ZeshuLiu/Joker60_V3.5/layout.jpg

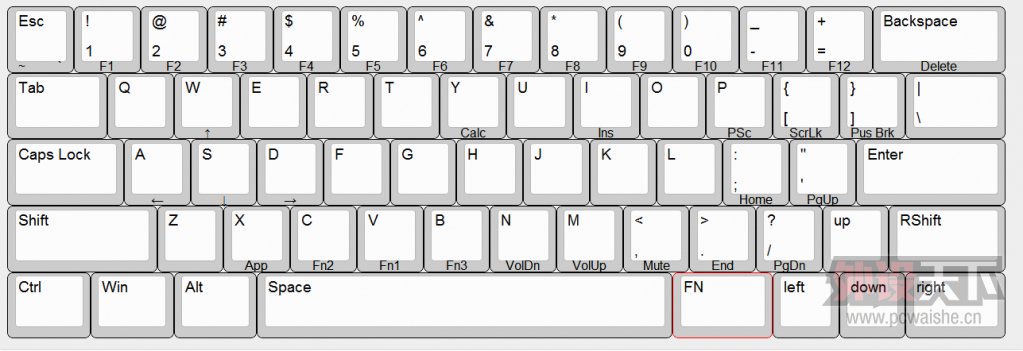
layout.jpg
