ZeshuLiu/Joker60_V3.5/Extension/Serial_DAP_Screen_back/Serial_Dap_Screen/Connector/SGDBM-08-014P-H10.stp

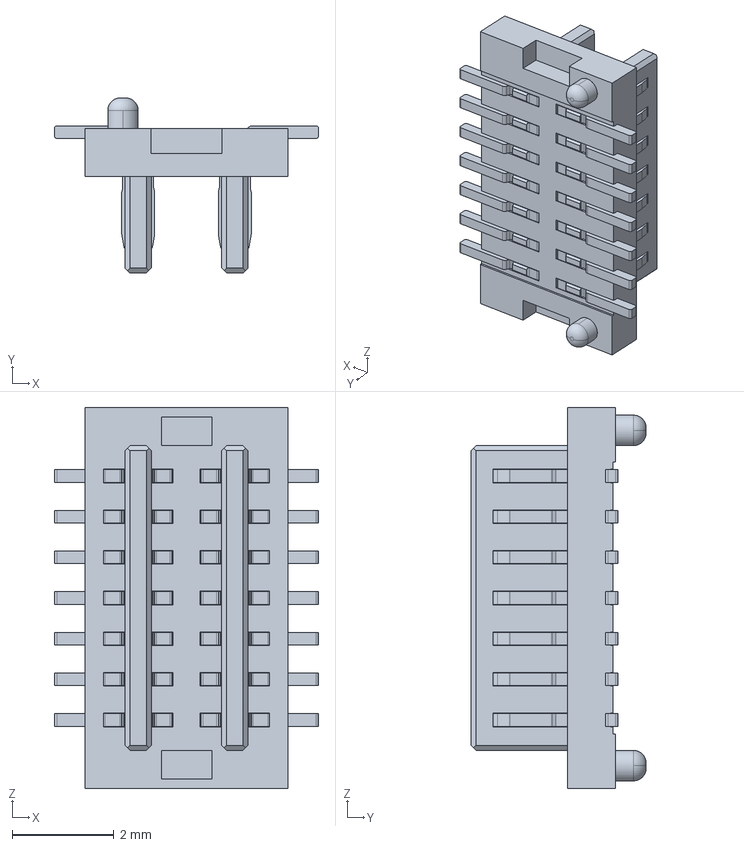
[picture p2: CAD file, 2023-10-21]
Extension/Serial_DAP_Screen_back/Serial_Dap_Screen/Connector/SGDBM-08-014P-H10.stp
5.20 x 3.45 x 7.50 mm
