ZeshuLiu/Joker60_V3.5/Joker60_V3.5/Connector_back/SGDBM-08-020P-H10.stp

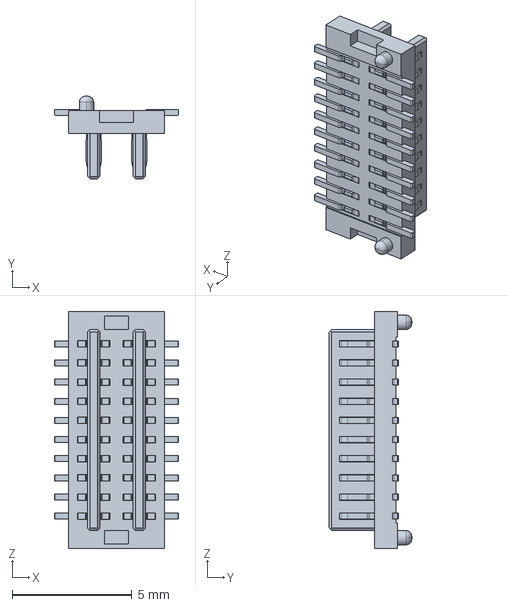
[picture p3: CAD file, 2023-10-21]
Joker60_V3.5/Connector_back/SGDBM-08-020P-H10.stp
5.20 x 3.45 x 9.90 mm
