ZeshuLiu/Joker60_V3.5/Joker60_V3.5/RP2040/RP2040.step

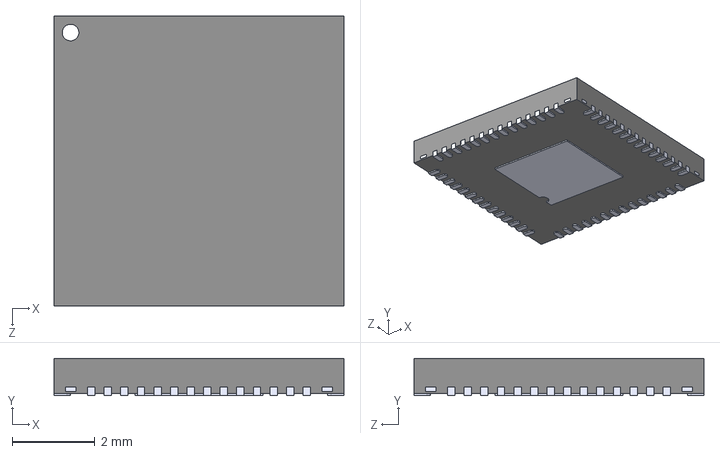
[picture p4: CAD file, 2023-08-13]
Joker60_V3.5/RP2040/RP2040.step
7.00 x 0.9 x 7.00 mm
