ZeshuLiu/Joker60_V3.5/Joker60_V3.5_CASE/Ver2/外壳.STEP

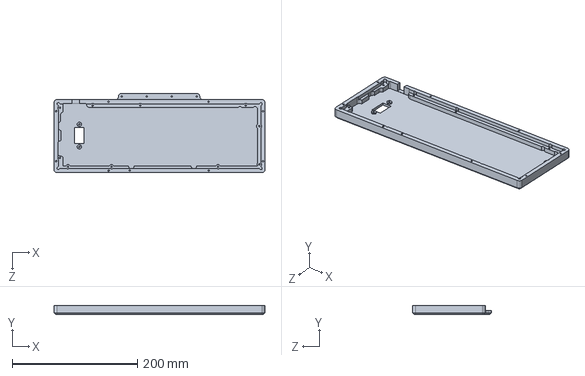
[picture p5: CAD file, 2026-01-21]
Joker60_V3.5_CASE/Ver2/外壳.STEP
337.3 x 15.0 x 126.9 mm
