ZeshuLiu/Joker60_V3.5/Joker60_V3.5_CASE/扩展/手机架子.SLDPRT

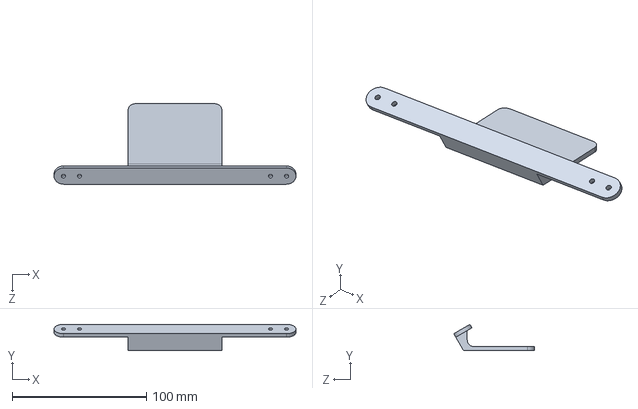
[picture p6: CAD file, 2023-11-28]
Joker60_V3.5_CASE/扩展/手机架子.SLDPRT
180.5 x 19.7 x 60.1 mm
