ZeshuLiu/Joker60_V3.5/Joker60_V3.5_CASE/Ver2/屏幕盖板.SLDPRT

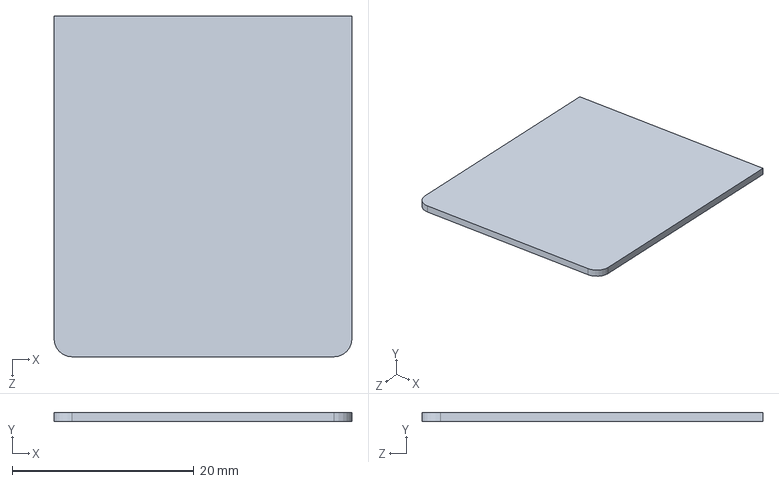
[picture p7: CAD file, 2026-01-21]
Joker60_V3.5_CASE/Ver2/屏幕盖板.SLDPRT
32.8 x 1.00 x 37.5 mm
