ZeshuLiu/Joker60_V3.5/Extension/Serial_DAP_Screen_back/Serial_Dap_Screen/Connector/SGDBF-08-014P-H30.stp

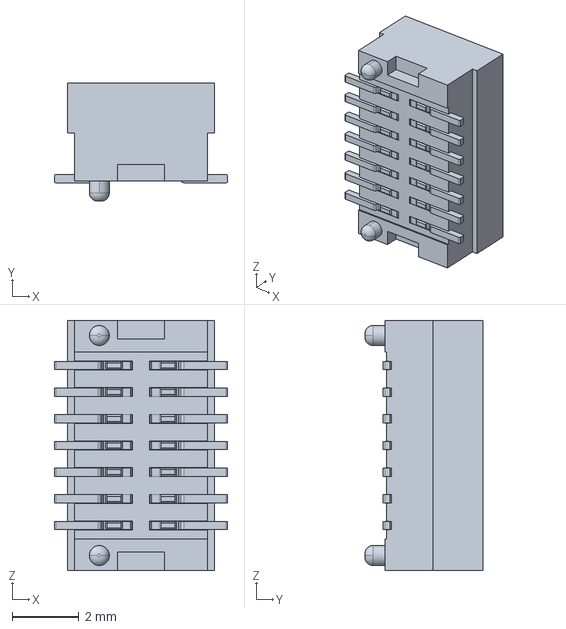
[picture p8: CAD file, 2023-08-15]
Extension/Serial_DAP_Screen_back/Serial_Dap_Screen/Connector/SGDBF-08-014P-H30.stp
5.20 x 3.55 x 7.50 mm
