ZeshuLiu/Joker60_V3.5/Joker60_V3.5/Connector_back/SGDBF-08-020P-H30.stp

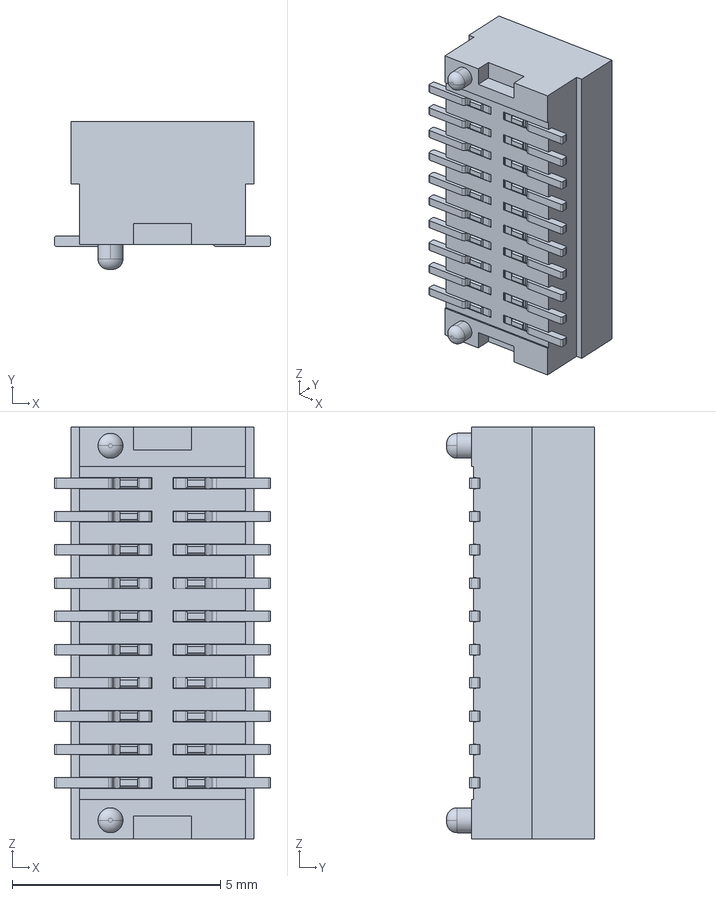
[picture p9: CAD file, 2023-08-15]
Joker60_V3.5/Connector_back/SGDBF-08-020P-H30.stp
5.20 x 3.55 x 9.90 mm
