ZeshuLiu/Joker60_V3.5/Joker60_V3.5_CASE/Ver2/盖子_Screen.STEP

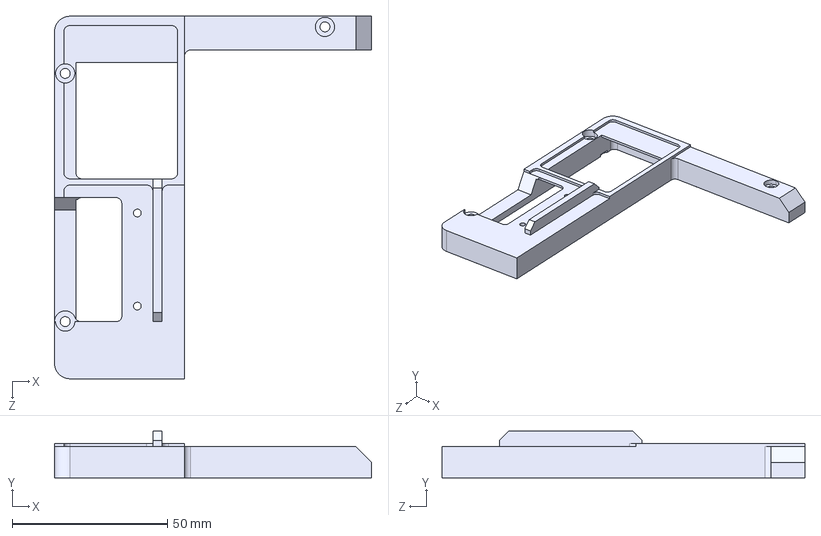
[picture p10: CAD file, 2026-01-21]
Joker60_V3.5_CASE/Ver2/盖子_Screen.STEP
102.2 x 15.0 x 116.9 mm
