ZeshuLiu/Joker60_V3.5/Joker60_V3.5_CASE/Ver2/盖子-space.SLDPRT

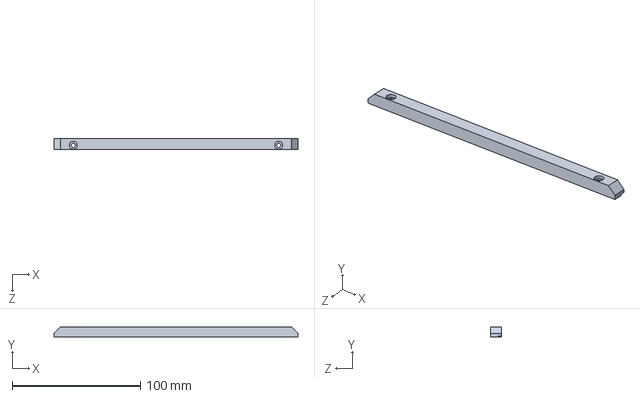
[picture p11: CAD file, 2026-01-21]
Joker60_V3.5_CASE/Ver2/盖子-space.SLDPRT
190.0 x 8.00 x 8.90 mm
