ZeshuLiu/Joker60_V3.5/Joker60_V3.5_CASE/Ver2/前脚垫.SLDPRT

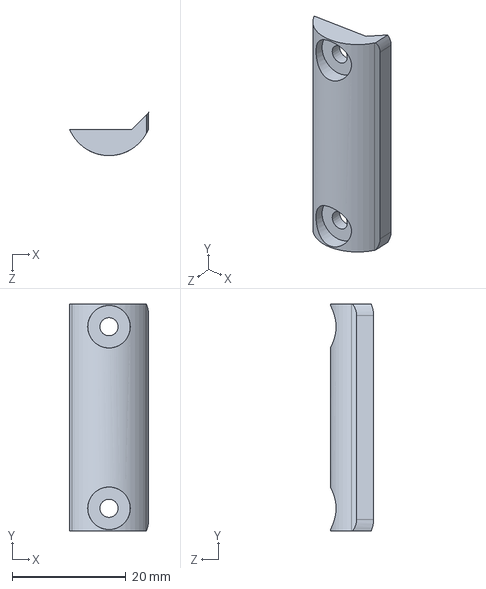
[picture p12: CAD file, 2026-01-21]
Joker60_V3.5_CASE/Ver2/前脚垫.SLDPRT
14.0 x 40.0 x 7.62 mm
