ZeshuLiu/Joker60_V3.5/Joker60_V3.5_CASE/Ver2/盖子-bacspace.SLDPRT

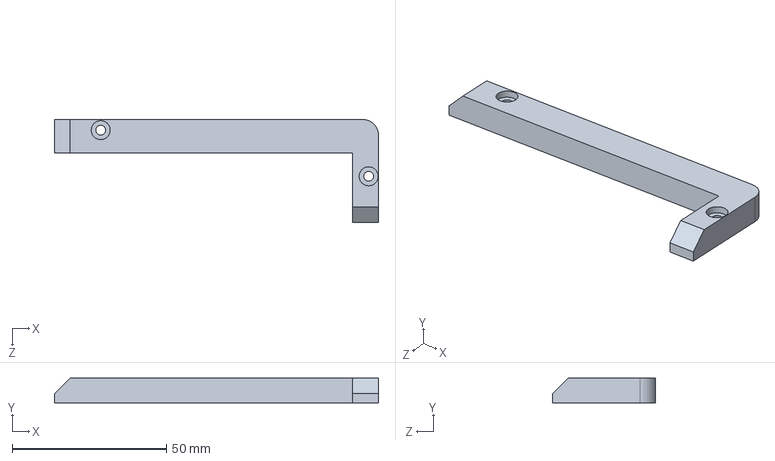
[picture p14: CAD file, 2026-01-21]
Joker60_V3.5_CASE/Ver2/盖子-bacspace.SLDPRT
105.2 x 8.00 x 33.4 mm
