ZeshuLiu/Joker60_V3.5/Joker60_V3.5_CASE/Ver2/1.69Screen.SLDPRT

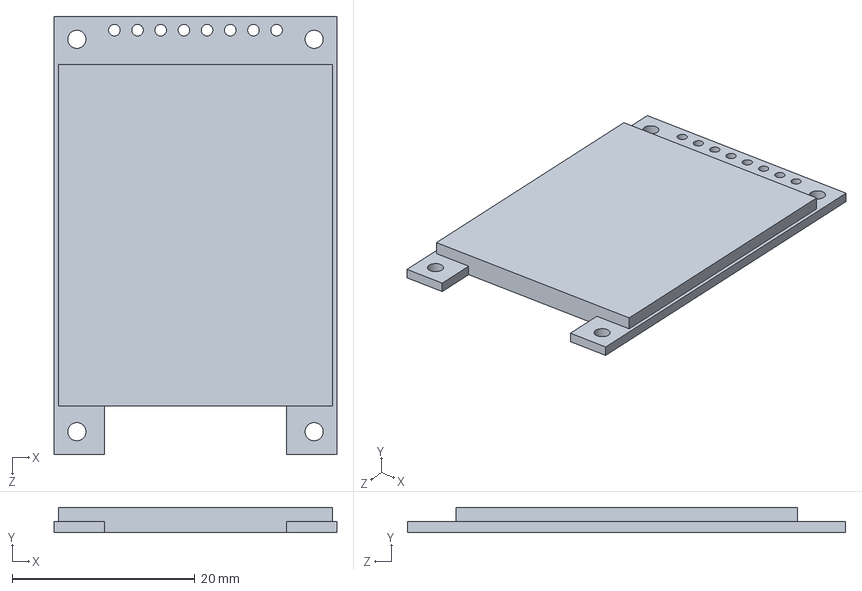
[picture p15: CAD file, 2025-12-26]
Joker60_V3.5_CASE/Ver2/1.69Screen.SLDPRT
31.0 x 2.76 x 48.0 mm
