ZeshuLiu/Joker60_V3.5/Joker60_V3.5_CASE/Ext/PhoneStand.SLDASM

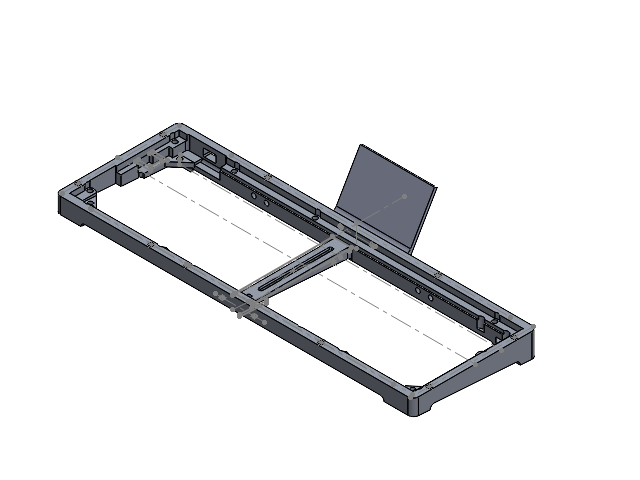
[picture p16: CAD file, 2023-11-28]
Joker60_V3.5_CASE/Ext/PhoneStand.SLDASM
手机架子
外壳
