ZeshuLiu/Joker60_V3.5/(list of files, cad)

Other CAD files:
Joker60_V3.5_CASE/Ext/PhoneStand.SLDPRT
Joker60_V3.5_CASE/Ext/PhoneStand.STL
Joker60_V3.5_CASE/Ver1/外壳.SLDPRT
Joker60_V3.5_CASE/Ver1/外壳.STEP
Joker60_V3.5_CASE/Ver1/盖子-bacspace.SLDPRT
Joker60_V3.5_CASE/Ver1/盖子-space.SLDPRT
Joker60_V3.5_CASE/Ver1/盖子_Screen.3mf
Joker60_V3.5_CASE/Ver1/盖子_Screen.SLDPRT
Joker60_V3.5_CASE/Ver2/前脚垫.STL
Joker60_V3.5_CASE/Ver2/后脚垫.STL
Joker60_V3.5_CASE/Ver2/外壳.SLDPRT
Joker60_V3.5_CASE/Ver2/屏幕盖板.SLDDRW
Joker60_V3.5_CASE/Ver2/盖子-bacspace.STL
Joker60_V3.5_CASE/Ver2/盖子-space.STL
Joker60_V3.5_CASE/Ver2/盖子_Screen.3mf
Joker60_V3.5_CASE/Ver2/盖子_Screen.SLDPRT
Joker60_V3.5_CASE/Ver2/盖子_Screen.STL
Joker60_V3.5_CASE/扩展/手机架子.STL
