ZeshuLiu/Joker60_V3.5/Extension/Screen_UART/Screen_UArt/Screen_UArt.kicad_pcb

## KiCad design Extension/Screen_UART/Screen_UArt/Screen_UArt.kicad_pcb (2023-10-28)

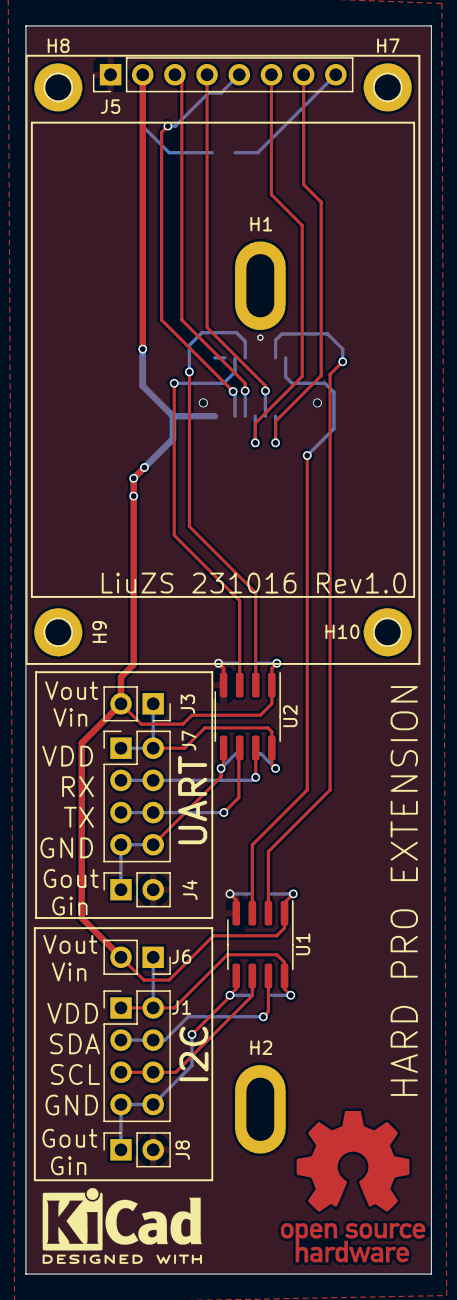
[picture p17: board Screen_UArt.kicad_pcb from above]

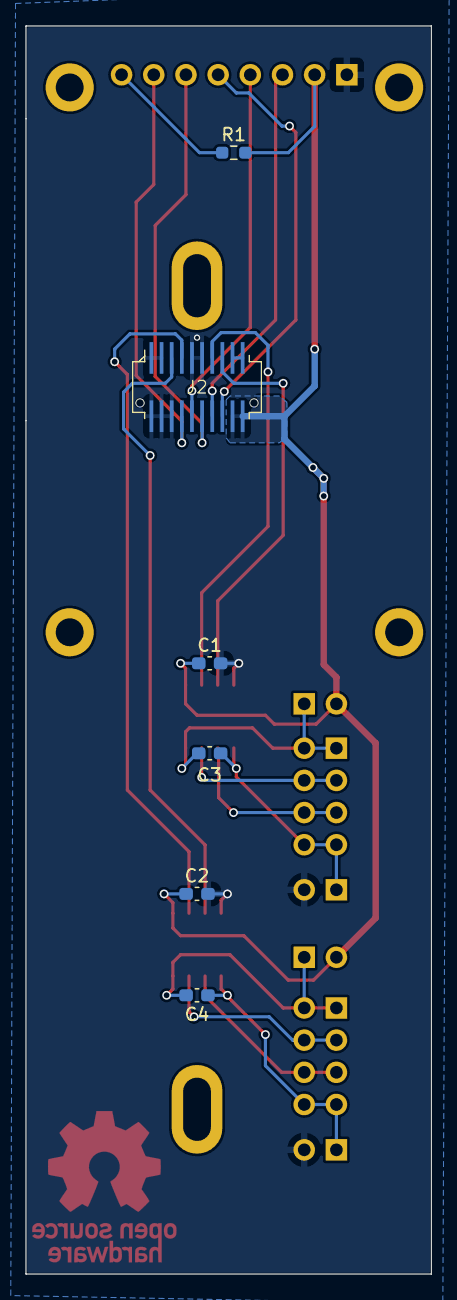
[picture p18: board Screen_UArt.kicad_pcb from below]

Board: 2 copper layers, 32.0 x 98.5 mm, 21 parts (6 on the bottom side), 21 nets.

Parts:
C1, C2, C3, C4: 100nf; C_0603_1608Metric_Pad1.08x0.95mm_HandSolder
H1, H2: MountingHole_Pad; MountingHole_M2_2.2x5mm_pad
H7, H8, H9, H10: MountingHole_Pad; MountingHole_2.2mm_M2_DIN965_Pad
J1, J7: Conn_02x04_Odd_Even; PinHeader_2x04_P2.54mm_Vertical
J2: Conn_02x10_Counter_Clockwise; BTB_0.8mm_2x10pin_Male
J3, J4, J6, J8: Conn_01x02_Pin; PinSocket_1x02_P2.54mm_Vertical
J5: Conn_01x08_Pin; PinHeader_1x08_P2.54mm_Vertical
R1: 10k; R_0603_1608Metric_Pad0.98x0.95mm_HandSolder
U1: ADuM1250; SOIC-8_3.9x4.9mm_P1.27mm
U2: ADuM1201BR; SOIC-8_3.9x4.9mm_P1.27mm

Connections:
+5V: J2.1, J2.2
/BLK: J5.8, R1.1
/MISO2: J2.16, J5.6
/MOSI2: J2.15, J5.4
/PB12: J2.18, J5.5
/PC8: J2.14, J5.7
/RXO: J7.3, J7.4, U2.7 (VIA)
/Rx6: J2.4, U2.2 (VOA)
/SCK2: J2.17, J5.3
/SCL3: J2.8, U1.3 (SCL1)
/SCLO: J1.5, J1.6, U1.6 (SCL2)
/SDA3: J2.7, U1.2 (SDA1)
/SDAO: J1.3, J1.4, U1.7 (SDA2)
/TXO: J7.5, J7.6, U2.6 (VOB)
/Tx6: J2.3, U2.3 (VIB)
GND: C1.2, C2.2, J2.5, J2.6, J2.9, J2.10, J2.11, J2.12, J2.13, J4.2, J5.1, J8.2, U1.4 (GND1), U2.4 (GND1)
GND1: C4.2, J1.7, J1.8, J8.1, U1.5 (GND2)
GNDA: C3.2, J4.1, J7.7, J7.8, U2.5 (GND2)
VDD: C1.1, C2.1, J2.19, J2.20, J3.2, J5.2, J6.2, R1.2, U1.1 (VDD1), U2.1 (VDD1)
VDDA: C3.1, J3.1, J7.1, J7.2, U2.8 (VDD2)
VDDF: C4.1, J1.1, J1.2, J6.1, U1.8 (VDD2)
