ZeshuLiu/Joker60_V3.5/Extension/Serial_DAP_Screen_back/Serial_Dap_Screen/Serial_Dap_Screen.kicad_pcb

## KiCad design Extension/Serial_DAP_Screen_back/Serial_Dap_Screen/Serial_Dap_Screen.kicad_pcb (2023-10-21)

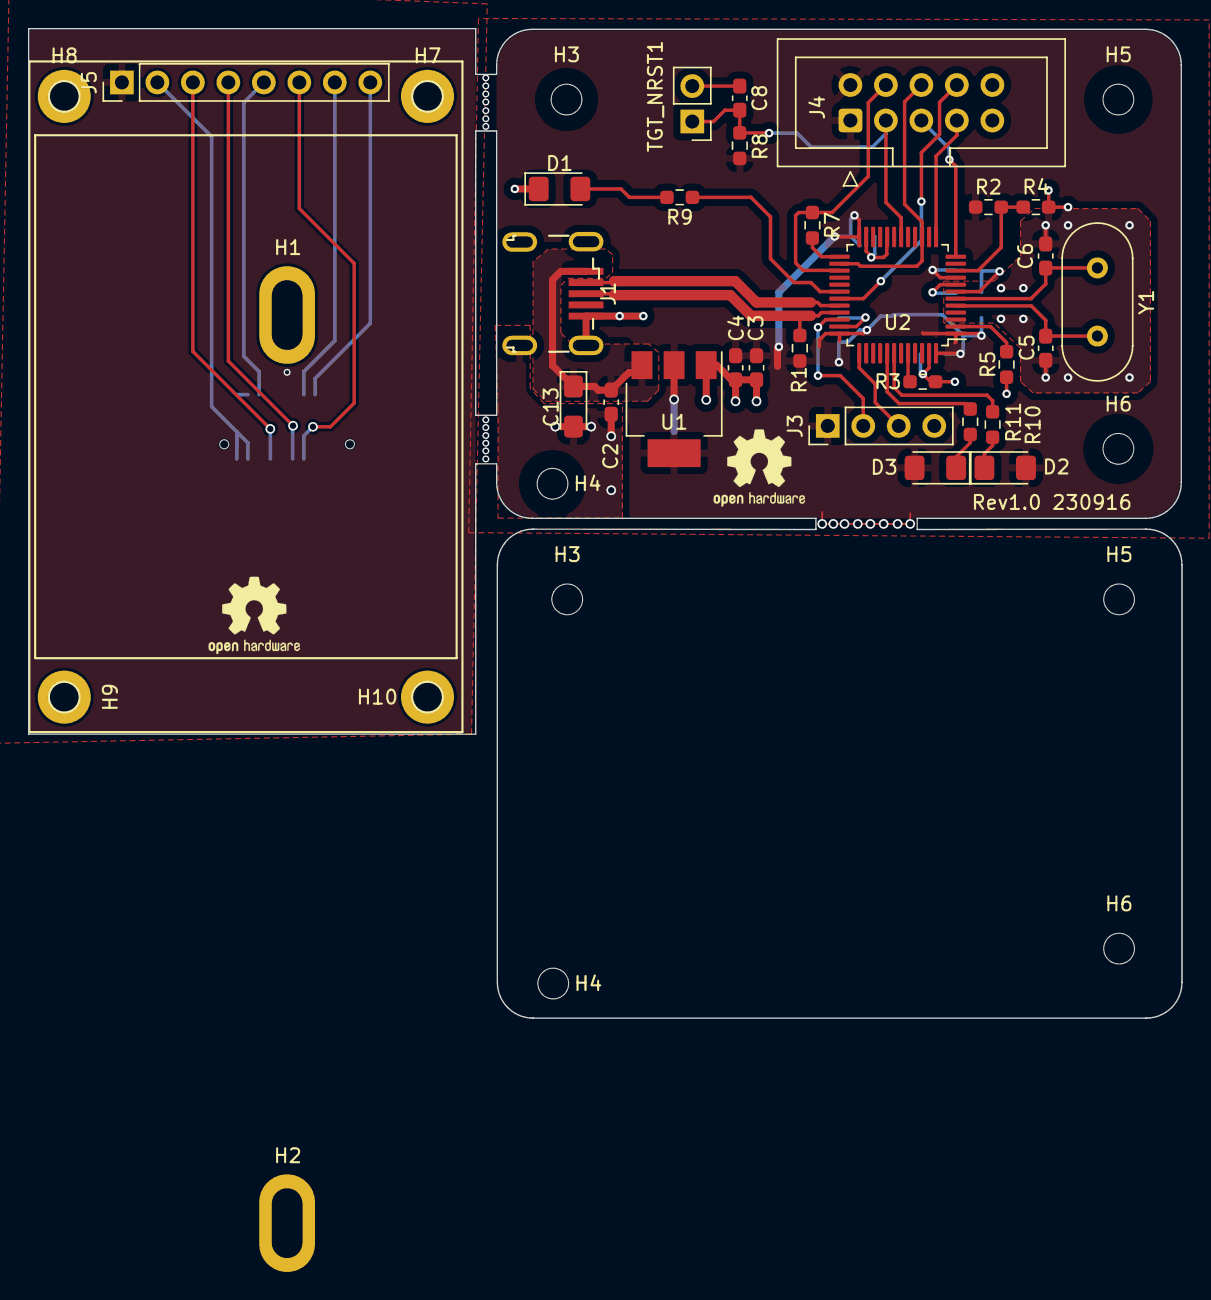
[picture p19: board Serial_Dap_Screen.kicad_pcb from above]

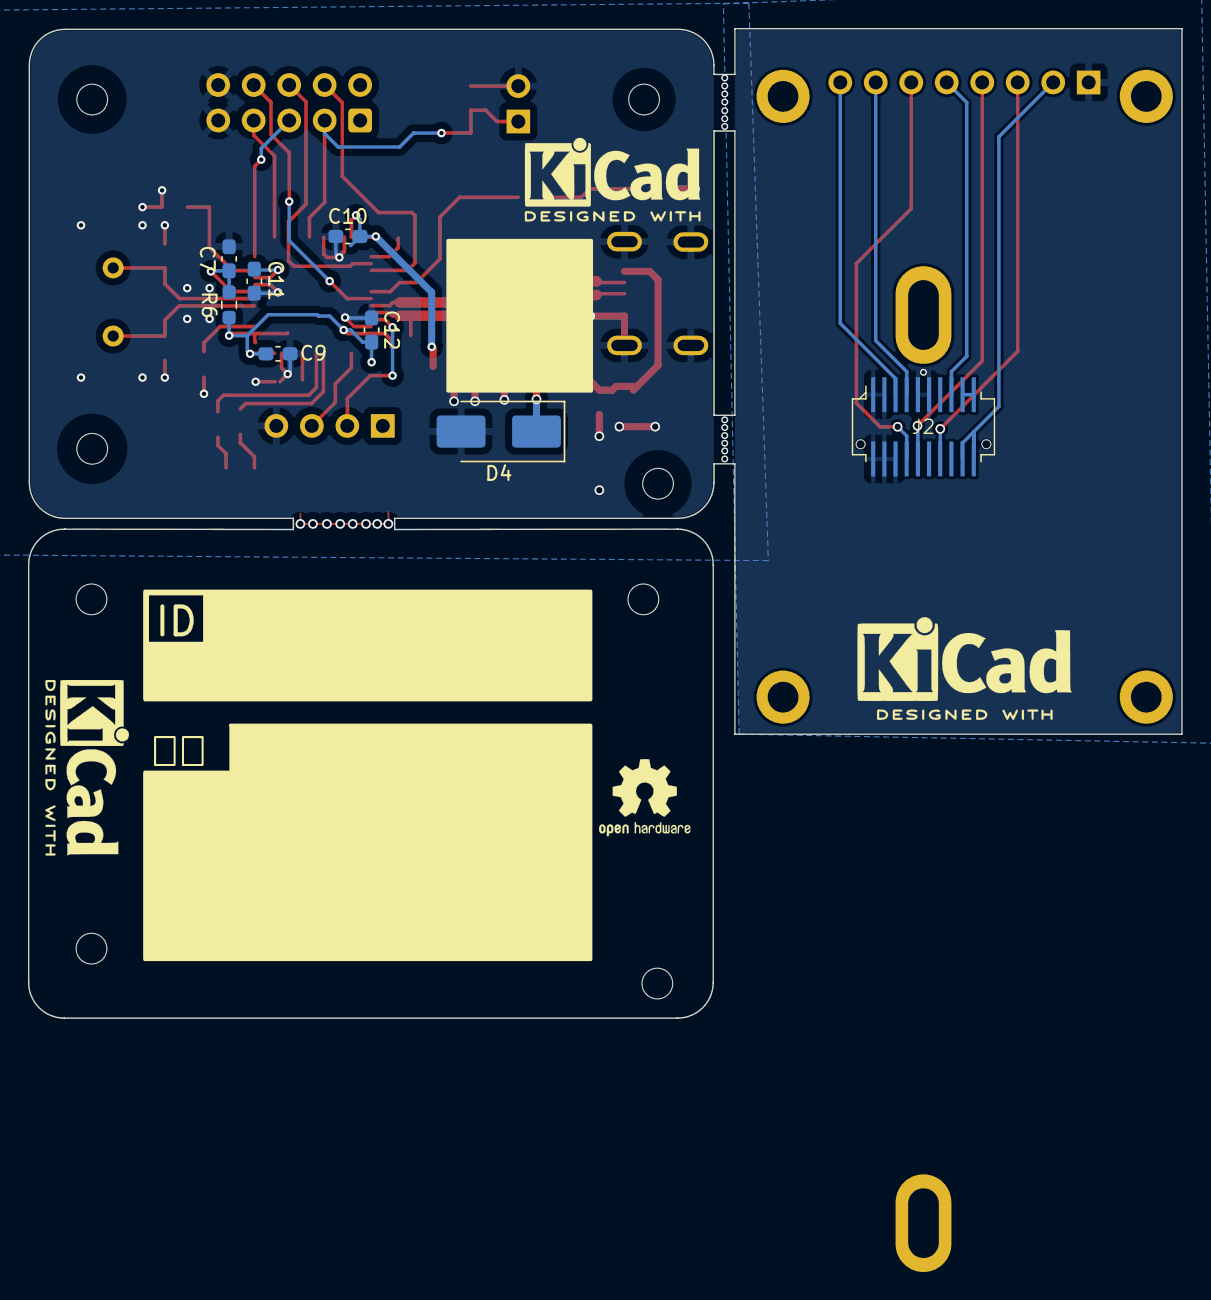
[picture p20: board Serial_Dap_Screen.kicad_pcb from below]

Board: 2 copper layers, 82.5 x 70.8 mm, 50 parts (8 on the bottom side), 32 nets.

Parts:
C2, C3, C7, C8, C9, C10, C11, C12: 100nf; C_0603_1608Metric_Pad1.08x0.95mm_HandSolder
C4: 10uf; C_0603_1608Metric_Pad1.08x0.95mm_HandSolder
C5, C6: 20pf; C_0603_1608Metric_Pad1.08x0.95mm_HandSolder
C13: 10uf; CP_EIA-3216-18_Kemet-A_Pad1.58x1.35mm_HandSolder
D1, D2, D3: LED; LED_1206_3216Metric_Pad1.42x1.75mm_HandSolder
D4: SMBJ3.3A; D_SMB_Handsoldering
H1, H2: MountingHole_Pad; MountingHole_M2_2.2x5mm_pad
H3, H3#2, H4, H4#2, H5, H5#2, H6, H6#2: MountingHole; MountingHole_2.2mm_M2
H7, H8, H9, H10: MountingHole_Pad; MountingHole_2.2mm_M2_DIN965_Pad
J1: USB_B_Mini; USB_Micro-B_4TH
J2: Conn_02x10_Counter_Clockwise; BTB_0.8mm_2x10pin_Male
J3: Conn_01x04_Pin; PinHeader_1x04_P2.54mm_Vertical
J4: Conn_02x05_Odd_Even; IDC-Header_2x05_P2.54mm_Vertical
J5: Conn_01x08_Pin; PinHeader_1x08_P2.54mm_Vertical
R1, R10: 1.5k; R_0603_1608Metric_Pad0.98x0.95mm_HandSolder
R2, R4: 4.7k; R_0603_1608Metric_Pad0.98x0.95mm_HandSolder
R3: 100k; R_0603_1608Metric_Pad0.98x0.95mm_HandSolder
R5, R6, R8: 10k; R_0603_1608Metric_Pad0.98x0.95mm_HandSolder
R7: 100; R_0603_1608Metric_Pad0.98x0.95mm_HandSolder
R9, R11: 470; R_0603_1608Metric_Pad0.98x0.95mm_HandSolder
TGT_NRST1: Conn_01x02_Pin; PinHeader_1x02_P2.54mm_Vertical
U1: AMS1117-3.3; SOT-223-3_TabPin2
U2: STM32F103CBTx; LQFP-48_7x7mm_P0.5mm
Y1: 8MHz; Crystal_HC49-U_Vertical

Connections:
+5V: C2.2, C13.1, J1.1 (VBUS), J2.1, J2.2, U1.3 (VI)
/IF_NRST: C7.2, R6.2, U2.7 (NRST)
/IF_SWCLK: J3.3, U2.37 (PA14)
/IF_SWDIO: J3.2, U2.34 (PA13)
/LED_COM_GREEN: R11.1, U2.41 (PB5)
/LED_DAP_BLUE: R10.1, U2.42 (PB6)
/LED_PWR_RED: R9.1, U2.30 (PA9)
/MOSI2: J2.15, J5.4
/PC8: J2.14, J5.6
/SCK2: J2.17, J5.3
/SCL3: J2.8, J5.8
/SDA3: J2.7, J5.7
/TGT_NRST: C8.2, J4.3, R8.2, TGT_NRST1.1, U2.18 (PB0)
/TGT_RX: J4.5, U2.12 (PA2)
/TGT_SWCLK: J4.6, U2.15 (PA5), U2.26 (PB13)
/TGT_SWDIO: J4.4, R7.1, U2.27 (PB14)
/TGT_SWO: J4.8, U2.31 (PA10)
/TGT_TX: J4.7, U2.13 (PA3)
/Tx6: J2.3, J5.5
/USB_D+: J1.3 (D+), R1.2, U2.33 (PA12)
/USB_D-: J1.2 (D-), U2.32 (PA11)
GND: C2.1, C3.1, C4.1, C5.1, C6.1, C7.1, C8.1, C9.1, C10.1, C11.1, C12.1, C13.2, D1.1 (K), D4.2 (A2), J1.5 (GND), J1.6 (Shield), J2.5, J2.6, J2.9, J2.10, J2.11, J2.12, J2.13, J3.4, J4.9, J4.10, J5.1, R3.1, R4.2, R5.2, TGT_NRST1.2, U1.1 (GND), U2.8 (VSSA), U2.20 (PB2), U2.23 (VSS), U2.35 (VSS), U2.47 (VSS)
unnamed: D1.2 (A), R9.2
unnamed: D2.1 (K), R10.2
unnamed: D3.1 (K), R11.2
unnamed: R3.2, U2.44 (BOOT0)
unnamed: R2.2, R4.1, U2.10 (PA0)
unnamed: R7.2, U2.25 (PB12)
unnamed: R5.1, U2.2 (PC13)
unnamed: C5.2, U2.5 (PD0), Y1.2
unnamed: C6.2, U2.6 (PD1), Y1.1
VDD: C3.2, C4.2, C9.2, C10.2, C11.2, C12.2, D2.2 (A), D3.2 (A), D4.1 (A1), J2.19, J2.20, J3.1, J4.1, J4.2, J5.2, R1.1, R2.1, R6.1, R8.1, U1.2 (VO), U2.1 (VBAT), U2.9 (VDDA), U2.24 (VDD), U2.36 (VDD), U2.48 (VDD)
