ZeshuLiu/Joker60_V3.5/Joker60_V3.5/Joker60_V3.5.kicad_sch

## KiCad design Joker60_V3.5/Joker60_V3.5.kicad_sch (2023-08-26)

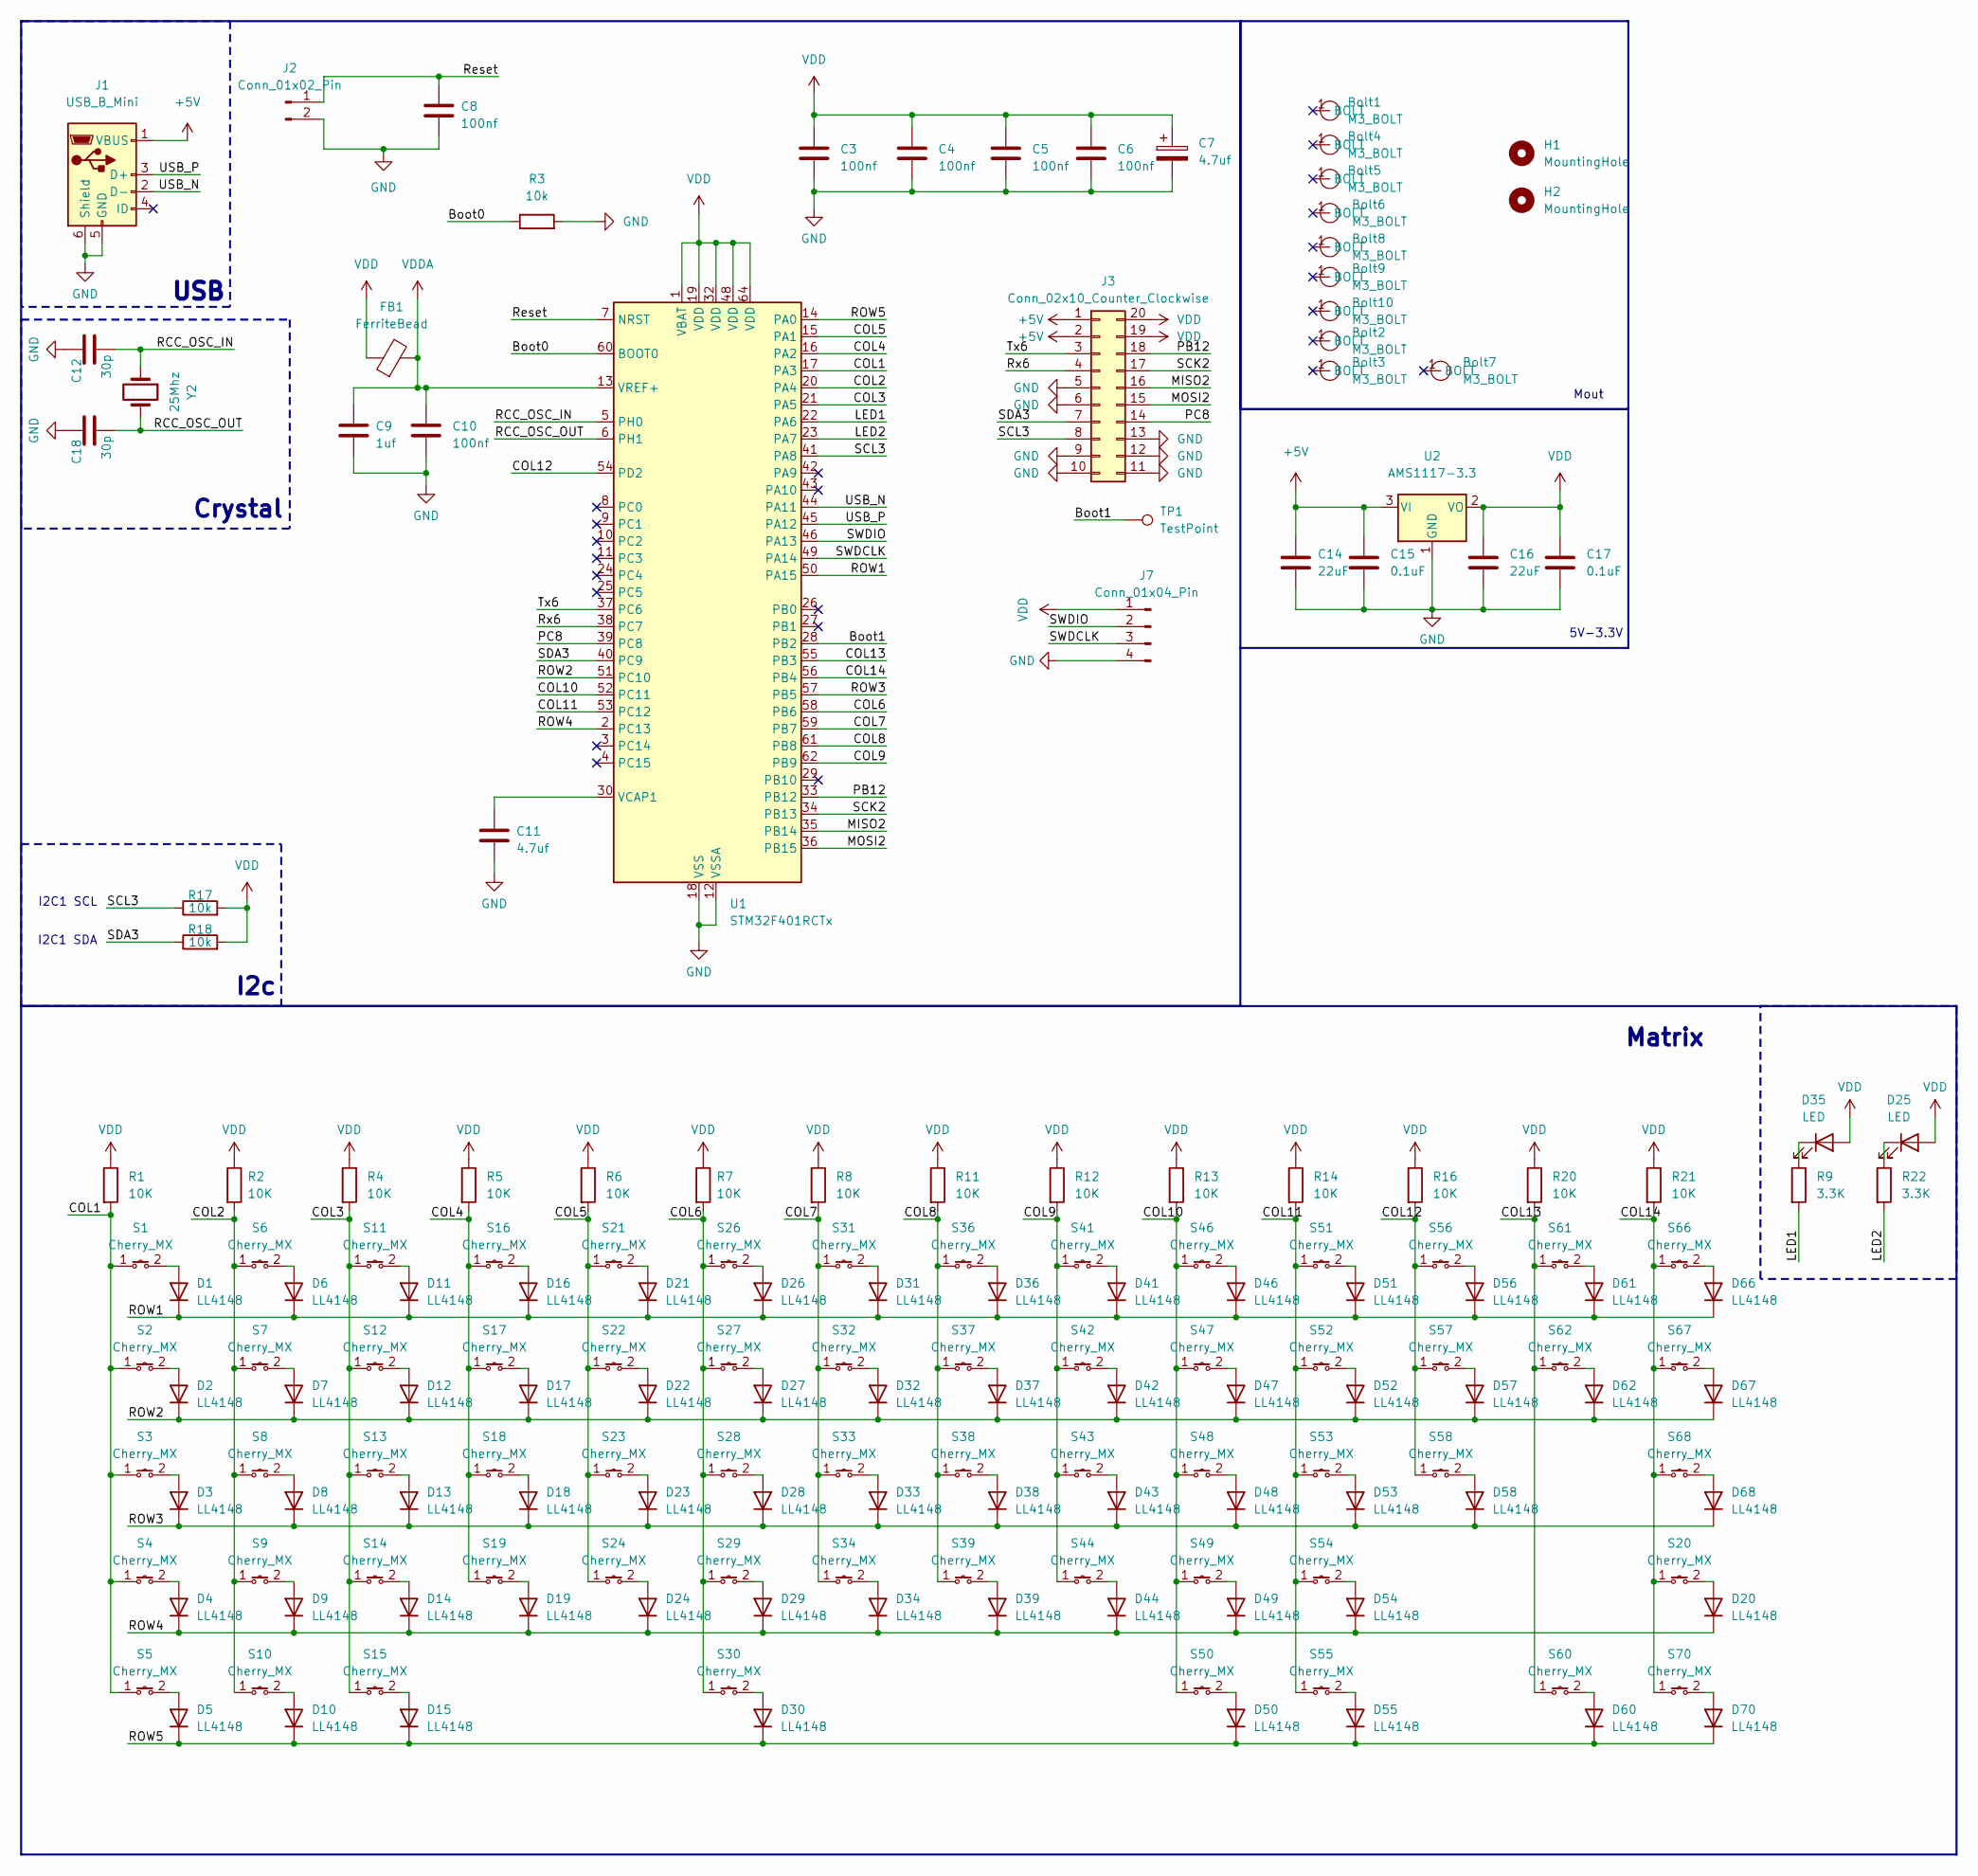
[picture p21: schematic Joker60_V3.5.kicad_sch]

Parts:
Bolt1, Bolt2, Bolt3, Bolt4, Bolt5, Bolt6, Bolt7, Bolt8, Bolt9, Bolt10: M3_BOLT; M3 BOLT
C3, C4, C5, C6, C8, C10: 100nf; C_0603_1608Metric
C7: 4.7uf; CP_EIA-3216-18_Kemet-A
C9: 1uf; C_0603_1608Metric
C11: 4.7uf; C_0603_1608Metric
C12, C18: 30p; C_0603_1608Metric
C14, C16: 22uF; C_0603_1608Metric
C15, C17: 0.1uF; C_0603_1608Metric
D1, D2, D3, D4, D5, D6, D7, D8, D9, D10, D11, D12, D13, D14, D15, D16, D17, D18, D19, D20, D21, D22, D23, D24, D26, D27, D28, D29, D30, D31, D32, D33, D34, D36, D37, D38, D39, D41, D42, D43, D44, D46, D47, D48, D49, D50, D51, D52, D53, D54, D55, D56, D57, D58, D60, D61, D62, D66, D67, D68, D70: LL4148; D_MiniMELF
D25, D35: LED; LED_1206_3216Metric_Pad1.42x1.75mm_HandSolder
FB1: FerriteBead; L_0805_2012Metric
H1, H2: MountingHole; MountingHole_2.2mm_M2_DIN965_Pad_TopBottom
J1: USB_B_Mini; USB_Micro-B_4TH
J2: Conn_01x02_Pin; PinHeader_1x02_P2.54mm_Vertical
J3: Conn_02x10_Counter_Clockwise; BTB_0.8mm_2x10pin_Female
J7: Conn_01x04_Pin; PinHeader_1x04_P2.54mm_Vertical
R1, R2, R4, R5, R6, R7, R8, R11, R12, R13, R14, R16, R20, R21: 10K; R_0603_1608Metric_Pad0.98x0.95mm_HandSolder
R3: 10k; R_0805_2012Metric
R9, R22: 3.3K; R_0603_1608Metric_Pad0.98x0.95mm_HandSolder
R17, R18: 10k; R_0603_1608Metric_Pad0.98x0.95mm_HandSolder
S1, S2, S3, S4, S5, S6, S7, S8, S9, S10, S11, S12, S13, S14, S15, S16, S17, S18, S19, S20, S21, S22, S23, S24, S26, S27, S28, S29, S30, S31, S32, S33, S34, S36, S37, S38, S39, S41, S42, S43, S44, S46, S47, S48, S49, S50, S51, S52, S53, S54, S55, S56, S57, S58, S60, S61, S62, S66, S67, S68, S70: Cherry_MX; SW_Hotswap_Kailh_MX_plated_1.00u
TP1: TestPoint; TestPoint_Pad_1.5x1.5mm
U1: STM32F401RCTx; LQFP-64_10x10mm_P0.5mm
U2: AMS1117-3.3; SOT-223-3_TabPin2
Y2: 25Mhz; Crystal_SMD_5032-2Pin_5.0x3.2mm

Connections:
+5V: C14.1, C15.1, J1.1 (VBUS), J3.1, J3.2, U2.3 (VI)
Boot0: R3.1, U1.60 (BOOT0)
Boot1: TP1.1, U1.28 (PB2)
COL1: R1.2, S1.1, S2.1, S3.1, S4.1, S5.1, U1.17 (PA3)
COL2: R2.2, S6.1, S7.1, S8.1, S9.1, S10.1, U1.20 (PA4)
COL3: R4.2, S11.1, S12.1, S13.1, S14.1, S15.1, U1.21 (PA5)
COL4: R5.2, S16.1, S17.1, S18.1, S19.1, U1.16 (PA2)
COL5: R6.2, S21.1, S22.1, S23.1, S24.1, U1.15 (PA1)
COL6: R7.2, S26.1, S27.1, S28.1, S29.1, S30.1, U1.58 (PB6)
COL7: R8.2, S31.1, S32.1, S33.1, S34.1, U1.59 (PB7)
COL8: R11.2, S36.1, S37.1, S38.1, S39.1, U1.61 (PB8)
COL9: R12.2, S41.1, S42.1, S43.1, S44.1, U1.62 (PB9)
COL10: R13.2, S46.1, S47.1, S48.1, S49.1, S50.1, U1.52 (PC11)
COL11: R14.2, S51.1, S52.1, S53.1, S54.1, S55.1, U1.53 (PC12)
COL12: R16.2, S56.1, S57.1, S58.1, U1.54 (PD2)
COL13: R20.2, S60.1, S61.1, S62.1, U1.55 (PB3)
COL14: R21.2, S20.1, S66.1, S67.1, S68.1, S70.1, U1.56 (PB4)
GND: C3.2, C4.2, C5.2, C6.2, C7.2, C8.2, C9.2, C10.2, C11.2, C12.1, C14.2, C15.2, C16.2, C17.2, C18.1, J1.5 (GND), J1.6 (Shield), J2.2, J3.5, J3.6, J3.9, J3.10, J3.11, J3.12, J3.13, J7.4, R3.2, U1.12 (VSSA), U1.18 (VSS), U1.31 (VSS), U1.47 (VSS), U1.63 (VSS), U2.1 (GND)
LED1: R9.2, U1.22 (PA6)
LED2: R22.2, U1.23 (PA7)
MISO2: J3.16, U1.35 (PB14)
MOSI2: J3.15, U1.36 (PB15)
unnamed: C11.1, U1.30 (VCAP1)
unnamed: D1.2 (A), S1.2
unnamed: D2.2 (A), S2.2
unnamed: D3.2 (A), S3.2
unnamed: D4.2 (A), S4.2
unnamed: D5.2 (A), S5.2
unnamed: D6.2 (A), S6.2
unnamed: D7.2 (A), S7.2
unnamed: D8.2 (A), S8.2
unnamed: D9.2 (A), S9.2
unnamed: D10.2 (A), S10.2
unnamed: D11.2 (A), S11.2
unnamed: D12.2 (A), S12.2
unnamed: D13.2 (A), S13.2
unnamed: D14.2 (A), S14.2
unnamed: D15.2 (A), S15.2
unnamed: D16.2 (A), S16.2
unnamed: D17.2 (A), S17.2
unnamed: D18.2 (A), S18.2
unnamed: D19.2 (A), S19.2
unnamed: D20.2 (A), S20.2
unnamed: D21.2 (A), S21.2
unnamed: D22.2 (A), S22.2
unnamed: D23.2 (A), S23.2
unnamed: D24.2 (A), S24.2
unnamed: D25.1 (K), R22.1
unnamed: D26.2 (A), S26.2
unnamed: D27.2 (A), S27.2
unnamed: D28.2 (A), S28.2
unnamed: D29.2 (A), S29.2
unnamed: D30.2 (A), S30.2
unnamed: D31.2 (A), S31.2
unnamed: D32.2 (A), S32.2
unnamed: D33.2 (A), S33.2
unnamed: D34.2 (A), S34.2
unnamed: D35.1 (K), R9.1
unnamed: D36.2 (A), S36.2
unnamed: D37.2 (A), S37.2
unnamed: D38.2 (A), S38.2
unnamed: D39.2 (A), S39.2
unnamed: D41.2 (A), S41.2
unnamed: D42.2 (A), S42.2
unnamed: D43.2 (A), S43.2
unnamed: D44.2 (A), S44.2
unnamed: D46.2 (A), S46.2
unnamed: D47.2 (A), S47.2
unnamed: D48.2 (A), S48.2
unnamed: D49.2 (A), S49.2
unnamed: D50.2 (A), S50.2
unnamed: D51.2 (A), S51.2
unnamed: D52.2 (A), S52.2
unnamed: D53.2 (A), S53.2
unnamed: D54.2 (A), S54.2
unnamed: D55.2 (A), S55.2
unnamed: D56.2 (A), S56.2
unnamed: D57.2 (A), S57.2
unnamed: D58.2 (A), S58.2
unnamed: D60.2 (A), S60.2
unnamed: D61.2 (A), S61.2
unnamed: D62.2 (A), S62.2
unnamed: D66.2 (A), S66.2
unnamed: D67.2 (A), S67.2
unnamed: D68.2 (A), S68.2
unnamed: D70.2 (A), S70.2
PB12: J3.18, U1.33 (PB12)
PC8: J3.14, U1.39 (PC8)
RCC_OSC_IN: C12.2, U1.5 (PH0), Y2.1
RCC_OSC_OUT: C18.2, U1.6 (PH1), Y2.2
ROW1: D1.1 (K), D6.1 (K), D11.1 (K), D16.1 (K), D21.1 (K), D26.1 (K), D31.1 (K), D36.1 (K), D41.1 (K), D46.1 (K), D51.1 (K), D56.1 (K), D61.1 (K), D66.1 (K), U1.50 (PA15)
ROW2: D2.1 (K), D7.1 (K), D12.1 (K), D17.1 (K), D22.1 (K), D27.1 (K), D32.1 (K), D37.1 (K), D42.1 (K), D47.1 (K), D52.1 (K), D57.1 (K), D62.1 (K), D67.1 (K), U1.51 (PC10)
ROW3: D3.1 (K), D8.1 (K), D13.1 (K), D18.1 (K), D23.1 (K), D28.1 (K), D33.1 (K), D38.1 (K), D43.1 (K), D48.1 (K), D53.1 (K), D58.1 (K), D68.1 (K), U1.57 (PB5)
ROW4: D4.1 (K), D9.1 (K), D14.1 (K), D19.1 (K), D20.1 (K), D24.1 (K), D29.1 (K), D34.1 (K), D39.1 (K), D44.1 (K), D49.1 (K), D54.1 (K), U1.2 (PC13)
ROW5: D5.1 (K), D10.1 (K), D15.1 (K), D30.1 (K), D50.1 (K), D55.1 (K), D60.1 (K), D70.1 (K), U1.14 (PA0)
Reset: C8.1, J2.1, U1.7 (NRST)
Rx6: J3.4, U1.38 (PC7)
SCK2: J3.17, U1.34 (PB13)
SCL3: J3.8, R17.1, U1.41 (PA8)
SDA3: J3.7, R18.1, U1.40 (PC9)
SWDCLK: J7.3, U1.49 (PA14)
SWDIO: J7.2, U1.46 (PA13)
Tx6: J3.3, U1.37 (PC6)
USB_N: J1.2 (D-), U1.44 (PA11)
USB_P: J1.3 (D+), U1.45 (PA12)
VDD: C3.1, C4.1, C5.1, C6.1, C7.1, C16.1, C17.1, D25.2 (A), D35.2 (A), FB1.1, J3.19, J3.20, J7.1, R1.1, R2.1, R4.1, R5.1, R6.1, R7.1, R8.1, R11.1, R12.1, R13.1, R14.1, R16.1, R17.2, R18.2, R20.1, R21.1, U1.1 (VBAT), U1.19 (VDD), U1.32 (VDD), U1.48 (VDD), U1.64 (VDD), U2.2 (VO)
VDDA: C9.1, C10.1, FB1.2, U1.13 (VREF+)

Notes on the sheet:
I2C1 SCL
I2C1 SDA
USB
Matrix
Mout
I2c
5V-3.3V
Crystal
