ZeshuLiu/Joker60_V3.5/Joker60_V3_5_Code/CubeMXProject/CubeMXProject.ioc

Mcu.UserName=STM32F401RCTx
PA0-WKUP.GPIO_Label=ROW5
PA0-WKUP.Signal=GPIO_Output
PA1.GPIO_Label=COL5
PA1.Signal=GPIO_Input
PA11.GPIO_Label=USB_N
PA11.Signal=USB_OTG_FS_DM
PA12.GPIO_Label=USB_P
PA12.Signal=USB_OTG_FS_DP
PA13.GPIO_Label=SWDIO
PA13.Signal=SYS_JTMS-SWDIO
PA14.GPIO_Label=SWDCLK
PA14.Signal=SYS_JTCK-SWCLK
PA15.GPIO_Label=ROW1
PA15.Signal=GPIO_Output
PA2.GPIO_Label=COL4
PA2.Signal=GPIO_Input
PA3.GPIO_Label=COL1
PA3.Signal=GPIO_Input
PA4.GPIO_Label=COL2
PA4.Signal=GPIO_Input
PA5.GPIO_Label=COL3
PA5.Signal=GPIO_Input
PA6.GPIO_Label=LED1
PA6.Signal=GPIO_Output
PA7.GPIO_Label=LED2
PA7.Signal=GPIO_Output
PA8.GPIO_Label=SCL3
PA8.Signal=I2C3_SCL
PB13.GPIO_Label=SCK2
PB13.Signal=SPI2_SCK
PB14.GPIO_Label=MISO2
PB14.Signal=SPI2_MISO
PB15.GPIO_Label=MOSI2
PB15.Signal=SPI2_MOSI
PB3.GPIO_Label=COL13
PB3.Signal=GPIO_Input
PB4.GPIO_Label=COL14
PB4.Signal=GPIO_Input
PB5.GPIO_Label=ROW3
PB5.Signal=GPIO_Output
PB6.GPIO_Label=COL6
PB6.Signal=GPIO_Input
PB7.GPIO_Label=COL7
PB7.Signal=GPIO_Input
PB8.GPIO_Label=COL8
PB8.Signal=GPIO_Input
PB9.GPIO_Label=COL9
PB9.Signal=GPIO_Input
PC10.GPIO_Label=ROW2
PC10.Signal=GPIO_Output
PC11.GPIO_Label=COL10
PC11.Signal=GPIO_Input
PC12.GPIO_Label=COL11
PC12.Signal=GPIO_Input
PC13-ANTI_TAMP.GPIO_Label=ROW4
PC13-ANTI_TAMP.Signal=GPIO_Output
PC6.GPIO_Label=TX6
PC6.Signal=USART6_TX
PC7.GPIO_Label=RX6
PC7.Signal=USART6_RX
PC9.GPIO_Label=SDA3
PC9.Signal=I2C3_SDA
PD2.GPIO_Label=COL12
PD2.Signal=GPIO_Input
