ZeshuLiu/Joker60_V3.5/Joker60_V3_5_Code/Composite/Core/Src/spi.c

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
/* Includes ------------------------------------------------------------------*/
#include "spi.h"

/* USER CODE BEGIN 0 */
volatile static const unsigned char dog_bmp [] ={
0xFF,0xFF,0xFF,0xFF,0xFF,0xFF,0xFF,0xFF,0xFF,0xFF,0xFF,0xFF,0xFF,0xFF,0xFF,0xFF,
0xFF,0xFF,0xFF,0xFF,0xFF,0xFF,0xFF,0xFF,0xFF,0xFF,0xFF,0xFF,0xFF,0xFF,0xFF,0xFF,
0xFF,0xFF,0xFF,0xFF,0xFF,0xFF,0xFF,0xFF,0x09,0x00,0xFF,0xFF,0xFF,0xFF,0xFF,0xFF,
0xFF,0xFF,0xFF,0xFF,0xFF,0xFF,0xFF,0x3F,0x1F,0x00,0xF0,0xFF,0xFF,0xFF,0xFF,0xFF,
0xFF,0xFF,0xFF,0xFF,0xFF,0xFF,0xFF,0xC3,0xFF,0xFF,0xC2,0xFF,0xFF,0xFF,0xFF,0xFF,
0xFF,0xFF,0xFF,0xFF,0xFF,0xFF,0x7F,0xF8,0xFF,0xFF,0x0F,0xFF,0xFF,0xFF,0xFF,0xFF,
0xFF,0xFF,0xFF,0xFF,0xFF,0xFF,0x0F,0xFC,0xFF,0xFF,0x3F,0xFC,0xFF,0xFF,0xFF,0xFF,
0xFF,0xFF,0xFF,0xFF,0xFF,0xFF,0x07,0xFE,0xFF,0xFF,0xFF,0xF8,0xFF,0xFF,0xFF,0xFF,
0xFF,0xFF,0xFF,0xFF,0xFF,0xFF,0x27,0xFF,0xFF,0xFA,0xFF,0xC1,0xFF,0xFF,0xFF,0xFF,
0xFF,0xFF,0xFF,0xFF,0xFF,0xFF,0x93,0x7F,0x7F,0xF8,0xFF,0x87,0xFF,0xFF,0xFF,0xFF,
0xFF,0xFF,0xFF,0xFF,0xFF,0xFF,0xB3,0x7F,0x78,0xFC,0xFF,0x3D,0xFF,0xFF,0xFF,0xFF,
0xFF,0xFF,0xFF,0xFF,0xFF,0xFF,0x19,0x1F,0x7E,0xFE,0x9F,0x39,0xFF,0xFF,0xFF,0xFF,
0xFF,0xFF,0xFF,0xFF,0xFF,0xFF,0x09,0x5E,0x7C,0xF8,0x1F,0x20,0xFE,0xFF,0xFF,0xFF,
0xFF,0xFF,0xFF,0xFF,0xFF,0xFF,0xDD,0xDF,0x3E,0xC0,0x31,0xE0,0xFC,0xFF,0xFF,0xFF,
0xFF,0xFF,0xFF,0xFF,0xFF,0xFF,0xE6,0xFB,0x3F,0x00,0xE1,0xC0,0xE1,0xFF,0xFF,0xFF,
0xFF,0xFF,0xFF,0xFF,0xFF,0x7F,0x26,0xF8,0x3F,0x00,0xE0,0xF8,0xE3,0xFF,0xFF,0xFF,
0xFF,0xFF,0xFF,0xFF,0xFF,0x7F,0x17,0xFC,0x7F,0x00,0x30,0xE0,0xC7,0xFF,0xFF,0xFF,
0xFF,0xFF,0xFF,0xFF,0xFF,0x9F,0x17,0xF8,0xFF,0x40,0x31,0xCE,0x0F,0xFF,0xFF,0xFF,
0xFF,0xFF,0xFF,0xFF,0xFF,0x8F,0x23,0xC6,0xFF,0xF1,0x38,0xFC,0x3F,0xFC,0xFF,0xFF,
0xFF,0xFF,0xFF,0xFF,0xFF,0xDF,0xE7,0x81,0xFF,0xFF,0x10,0xFD,0x5F,0xF0,0xFF,0xFF,
0xFF,0xFF,0xFF,0xFF,0xFF,0xDF,0xE3,0x88,0xFF,0x7F,0x1E,0xFF,0x87,0xFF,0xFF,0xFF,
0xFF,0xFF,0xFF,0xFF,0xFF,0xCF,0x23,0x3E,0xFF,0x7F,0x3E,0xFE,0x1F,0xFE,0xFF,0xFF,
0xFF,0xFF,0xFF,0xFF,0xFF,0xCF,0x83,0x3F,0xFF,0x3F,0x1F,0xFC,0x3F,0xFF,0xFF,0xFF,
0xFF,0xFF,0xFF,0xFF,0xFF,0xCF,0xC3,0x69,0xFE,0x3F,0xBF,0xFD,0x7F,0xFE,0xFF,0xFF,
0xFF,0xFF,0xFF,0xFF,0xFF,0xE7,0x37,0xC0,0xFC,0xFF,0x1F,0xFF,0x3F,0xFF,0xFF,0xFF,
0xFF,0xFF,0xFF,0xFF,0xFF,0xC3,0x17,0x80,0xFF,0xFF,0x3F,0xFF,0x3F,0xFF,0xFF,0xFF,
0xFF,0xFF,0xFF,0xFF,0xFF,0xCB,0x87,0x07,0x7F,0xFF,0x9F,0xFF,0x8F,0xFF,0xFF,0xFF,
0xFF,0xFF,0xFF,0xFF,0xFF,0xCF,0xC7,0x15,0x7E,0xFE,0x8F,0xFF,0xCF,0xFF,0xFF,0xFF,
0xFF,0xFF,0xFF,0xFF,0xFF,0xC7,0x07,0x01,0xBF,0xFE,0xA7,0xFF,0xE3,0xFF,0xFF,0xFF,
0xFF,0xFF,0xFF,0xFF,0xFF,0xEF,0x07,0x00,0x7E,0xFC,0x9F,0xFF,0xF3,0xFF,0xFF,0xFF,
0xFF,0xFF,0xFF,0xFF,0xFF,0x1F,0x06,0x00,0x7F,0xFA,0xFF,0xFF,0xFB,0xFF,0xFF,0xFF,
0xFF,0xFF,0xFF,0xFF,0xFF,0x1F,0x1B,0x14,0xFF,0xFE,0xFF,0xFF,0xF9,0xFF,0xFF,0xFF,
0xFF,0xFF,0xFF,0xFF,0xFF,0x6F,0x97,0x88,0x7F,0xFC,0xFF,0x7F,0xFE,0xFF,0xFF,0xFF,
0xFF,0xFF,0xFF,0xFF,0xFF,0x7F,0x3B,0x00,0xFF,0xFC,0xFB,0x7F,0xFC,0xFF,0xFF,0xFF,
0xFF,0xFF,0xFF,0xFF,0xFF,0xFF,0x76,0x80,0x7F,0xFE,0xFD,0xFF,0xFC,0xFF,0xFF,0xFF,
0xFF,0xFF,0xFF,0xFF,0xFF,0xFF,0x76,0x00,0xFF,0xFE,0xF9,0xEF,0xFC,0xFF,0xFF,0xFF,
0xFF,0xFF,0xFF,0xFF,0xFF,0xFF,0xFE,0x00,0xFF,0xFE,0xE4,0xF3,0xF8,0xFF,0xFF,0xFF,
0xFF,0xFF,0xFF,0xFF,0xFF,0xFF,0x74,0x08,0xFF,0xFF,0x1C,0x30,0xFC,0xFF,0xFF,0xFF,
0xFF,0xFF,0xFF,0xFF,0xFF,0xFF,0x70,0x34,0xFE,0x3F,0x1E,0xB0,0xFE,0xFF,0xFF,0xFF,
0xFF,0xFF,0xFF,0xFF,0xFF,0x7F,0x70,0xC2,0xFC,0x1F,0x4E,0x0E,0xFE,0xFF,0xFF,0xFF,
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
/* USER CODE END 0 */

SPI_HandleTypeDef hspi2;
DMA_HandleTypeDef hdma_spi2_tx;

/* SPI2 init function */
void MX_SPI2_Init(void)
{

  hspi2.Instance = SPI2;
  hspi2.Init.Mode = SPI_MODE_MASTER;
  hspi2.Init.Direction = SPI_DIRECTION_2LINES;
  hspi2.Init.DataSize = SPI_DATASIZE_8BIT;
  hspi2.Init.CLKPolarity = SPI_POLARITY_HIGH;
  hspi2.Init.CLKPhase = SPI_PHASE_2EDGE;
  hspi2.Init.NSS = SPI_NSS_SOFT;
  hspi2.Init.BaudRatePrescaler = SPI_BAUDRATEPRESCALER_16;
  hspi2.Init.FirstBit = SPI_FIRSTBIT_MSB;
  hspi2.Init.TIMode = SPI_TIMODE_DISABLE;
  hspi2.Init.CRCCalculation = SPI_CRCCALCULATION_DISABLE;
  hspi2.Init.CRCPolynomial = 10;
  if (HAL_SPI_Init(&hspi2) != HAL_OK)
  {
    Error_Handler();
  }
}

void HAL_SPI_MspInit(SPI_HandleTypeDef* spiHandle)
{

  GPIO_InitTypeDef GPIO_InitStruct = {0};
  if(spiHandle->Instance==SPI2)
  {
    /* SPI2 clock enable */
    __HAL_RCC_SPI2_CLK_ENABLE();

    __HAL_RCC_GPIOB_CLK_ENABLE();
    /**SPI2 GPIO Configuration
    PB13     ------> SPI2_SCK
    PB15     ------> SPI2_MOSI
    */
    GPIO_InitStruct.Pin = SCK2_Pin|MOSI2_Pin;
    GPIO_InitStruct.Mode = GPIO_MODE_AF_PP;
    GPIO_InitStruct.Pull = GPIO_NOPULL;
    GPIO_InitStruct.Speed = GPIO_SPEED_FREQ_VERY_HIGH;
    GPIO_InitStruct.Alternate = GPIO_AF5_SPI2;
    HAL_GPIO_Init(GPIOB, &GPIO_InitStruct);

    /* SPI2 DMA Init */
    /* SPI2_TX Init */
    hdma_spi2_tx.Instance = DMA1_Stream4;
    hdma_spi2_tx.Init.Channel = DMA_CHANNEL_0;
    hdma_spi2_tx.Init.Direction = DMA_MEMORY_TO_PERIPH;
    hdma_spi2_tx.Init.PeriphInc = DMA_PINC_DISABLE;
    hdma_spi2_tx.Init.MemInc = DMA_MINC_ENABLE;
    hdma_spi2_tx.Init.PeriphDataAlignment = DMA_PDATAALIGN_BYTE;
    hdma_spi2_tx.Init.MemDataAlignment = DMA_MDATAALIGN_BYTE;
    hdma_spi2_tx.Init.Mode = DMA_NORMAL;
    hdma_spi2_tx.Init.Priority = DMA_PRIORITY_LOW;
    hdma_spi2_tx.Init.FIFOMode = DMA_FIFOMODE_DISABLE;
    if (HAL_DMA_Init(&hdma_spi2_tx) != HAL_OK)
    {
      Error_Handler();
    }

    __HAL_LINKDMA(spiHandle,hdmatx,hdma_spi2_tx);

  }
}

void HAL_SPI_MspDeInit(SPI_HandleTypeDef* spiHandle)
{

  if(spiHandle->Instance==SPI2)
  {
    /* Peripheral clock disable */
    __HAL_RCC_SPI2_CLK_DISABLE();

    /**SPI2 GPIO Configuration
    PB13     ------> SPI2_SCK
    PB15     ------> SPI2_MOSI
    */
    HAL_GPIO_DeInit(GPIOB, SCK2_Pin|MOSI2_Pin);

    /* SPI2 DMA DeInit */
    HAL_DMA_DeInit(spiHandle->hdmatx);
  }
}
