ZeshuLiu/Joker60_V3.5/Joker60_V3_5_Code/Composite/Core/Src/usart.c

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
/* Includes ------------------------------------------------------------------*/
#include "usart.h"

/* USER CODE BEGIN 0 */

uint8_t UART6_RX_BUFFER[UART6_MAX_RX_LEN] = {0};

extern char CMD_BUFFER[MAX_DISP_ROW][MAX_DISP_LEN+1];
extern uint8_t CMD_DIR[MAX_DISP_ROW];
extern uint8_t CMD_LEN[MAX_DISP_ROW];
extern uint8_t CMD_POINTER;

extern uint16_t RX_CNT;
/* USER CODE END 0 */

UART_HandleTypeDef huart6;
DMA_HandleTypeDef hdma_usart6_rx;
DMA_HandleTypeDef hdma_usart6_tx;

/* USART6 init function */

void MX_USART6_UART_Init(void)
{

  huart6.Instance = USART6;
  huart6.Init.BaudRate = 115200;
  huart6.Init.WordLength = UART_WORDLENGTH_8B;
  huart6.Init.StopBits = UART_STOPBITS_1;
  huart6.Init.Parity = UART_PARITY_NONE;
  huart6.Init.Mode = UART_MODE_TX_RX;
  huart6.Init.HwFlowCtl = UART_HWCONTROL_NONE;
  huart6.Init.OverSampling = UART_OVERSAMPLING_16;
  if (HAL_UART_Init(&huart6) != HAL_OK)
  {
    Error_Handler();
  }
}

void HAL_UART_MspInit(UART_HandleTypeDef* uartHandle)
{

  GPIO_InitTypeDef GPIO_InitStruct = {0};
  if(uartHandle->Instance==USART6)
  {
    /* USART6 clock enable */
    __HAL_RCC_USART6_CLK_ENABLE();

    __HAL_RCC_GPIOC_CLK_ENABLE();
    /**USART6 GPIO Configuration
    PC6     ------> USART6_TX
    PC7     ------> USART6_RX
    */
    GPIO_InitStruct.Pin = TX6_Pin|RX6_Pin;
    GPIO_InitStruct.Mode = GPIO_MODE_AF_PP;
    GPIO_InitStruct.Pull = GPIO_NOPULL;
    GPIO_InitStruct.Speed = GPIO_SPEED_FREQ_VERY_HIGH;
    GPIO_InitStruct.Alternate = GPIO_AF8_USART6;
    HAL_GPIO_Init(GPIOC, &GPIO_InitStruct);

    /* USART6 DMA Init */
    /* USART6_RX Init */
    hdma_usart6_rx.Instance = DMA2_Stream1;
    hdma_usart6_rx.Init.Channel = DMA_CHANNEL_5;
    hdma_usart6_rx.Init.Direction = DMA_PERIPH_TO_MEMORY;
    hdma_usart6_rx.Init.PeriphInc = DMA_PINC_DISABLE;
    hdma_usart6_rx.Init.MemInc = DMA_MINC_ENABLE;
    hdma_usart6_rx.Init.PeriphDataAlignment = DMA_PDATAALIGN_BYTE;
    hdma_usart6_rx.Init.MemDataAlignment = DMA_MDATAALIGN_BYTE;
    hdma_usart6_rx.Init.Mode = DMA_NORMAL;
    hdma_usart6_rx.Init.Priority = DMA_PRIORITY_HIGH;
    hdma_usart6_rx.Init.FIFOMode = DMA_FIFOMODE_DISABLE;
    if (HAL_DMA_Init(&hdma_usart6_rx) != HAL_OK)
    {
      Error_Handler();
    }

    __HAL_LINKDMA(uartHandle,hdmarx,hdma_usart6_rx);

    /* USART6_TX Init */
    hdma_usart6_tx.Instance = DMA2_Stream6;
    hdma_usart6_tx.Init.Channel = DMA_CHANNEL_5;
    hdma_usart6_tx.Init.Direction = DMA_MEMORY_TO_PERIPH;
    hdma_usart6_tx.Init.PeriphInc = DMA_PINC_DISABLE;
    hdma_usart6_tx.Init.MemInc = DMA_MINC_ENABLE;
    hdma_usart6_tx.Init.PeriphDataAlignment = DMA_PDATAALIGN_BYTE;
    hdma_usart6_tx.Init.MemDataAlignment = DMA_MDATAALIGN_BYTE;
    hdma_usart6_tx.Init.Mode = DMA_NORMAL;
    hdma_usart6_tx.Init.Priority = DMA_PRIORITY_HIGH;
    hdma_usart6_tx.Init.FIFOMode = DMA_FIFOMODE_DISABLE;
    if (HAL_DMA_Init(&hdma_usart6_tx) != HAL_OK)
    {
      Error_Handler();
    }

    __HAL_LINKDMA(uartHandle,hdmatx,hdma_usart6_tx);

    /* USART6 interrupt Init */
    HAL_NVIC_SetPriority(USART6_IRQn, 5, 0);
    HAL_NVIC_EnableIRQ(USART6_IRQn);
  }
}

void HAL_UART_MspDeInit(UART_HandleTypeDef* uartHandle)
{

  if(uartHandle->Instance==USART6)
  {
    /* Peripheral clock disable */
    __HAL_RCC_USART6_CLK_DISABLE();

    /**USART6 GPIO Configuration
    PC6     ------> USART6_TX
    PC7     ------> USART6_RX
    */
    HAL_GPIO_DeInit(GPIOC, TX6_Pin|RX6_Pin);

    /* USART6 DMA DeInit */
    HAL_DMA_DeInit(uartHandle->hdmarx);
    HAL_DMA_DeInit(uartHandle->hdmatx);

    /* USART6 interrupt Deinit */
    HAL_NVIC_DisableIRQ(USART6_IRQn);
  }
}

/* USER CODE BEGIN 1 */
/**
 * @brief 重新设定UART参数
 * 
 * @param uart 要重新设定的uart handle
 * @param baudrate 重设波特率
 * @return HAL_StatusTypeDef 
 */
HAL_StatusTypeDef UpDateUart(UART_HandleTypeDef * uart, uint32_t baudrate)
{
  uint8_t if_change = 0;

  if (baudrate != uart->Init.BaudRate)
  {
    uart -> Init.BaudRate = baudrate;
    if_change = 1;
  }
  

  if (if_change)
  {
    HAL_UART_DeInit(uart);
    HAL_UART_Init(uart);
  }
  return HAL_UARTEx_ReceiveToIdle_DMA(&huart6, UART6_RX_BUFFER, UART6_MAX_RX_LEN);
}


void HAL_UARTEx_RxEventCallback(UART_HandleTypeDef *huart, uint16_t Size)
{
  // uint8_t len;
	// uint8_t data[25];
	if(huart->Instance == USART6)
	{
		HAL_UART_DMAStop(huart);
		CDC_Transmit(0, UART6_RX_BUFFER, Size);
    memset(CMD_BUFFER[CMD_POINTER], ' ' , MAX_DISP_LEN);    // 清屏，所以需要用空格填充！
    memcpy(CMD_BUFFER[CMD_POINTER], UART6_RX_BUFFER, ((int)Size>MAX_DISP_LEN) ? MAX_DISP_LEN:(int)Size);
    CMD_DIR[CMD_POINTER] = 2;
    CMD_LEN[CMD_POINTER] = Size;
    RX_CNT+=Size;
    CMD_POINTER = (CMD_POINTER + 1) % MAX_DISP_ROW;
    HAL_UARTEx_ReceiveToIdle_DMA(&huart6, UART6_RX_BUFFER, UART6_MAX_RX_LEN);
	}

}

void HAL_UART_TxCpltCallback(UART_HandleTypeDef *huart)
{
	extern uint8_t uart_busy;

	if (huart == &huart6)
	{
		uart_busy = 0;
	}
}

/* USER CODE END 1 */
