ZeshuLiu/Joker60_V3.5/Joker60_V3_5_Code/CubeMXProject/KeyScan/Layout.c

#include "Layout.h"
#include "KeyValue.h"



uint16_t LED2_Blink_Int = LED2_Blink_Idle;

/* Matrix Connection BEGIN */
GPIO_TypeDef *KeyboardColListPort[KeyBoardColCount] = {
    GPIOA,     GPIOA,      GPIOA,      GPIOA,       //4
    GPIOA,      GPIOB,      GPIOB,      GPIOB,      //8
    GPIOB,      GPIOC,      GPIOC,      GPIOD,      //12
    GPIOB,      GPIOB                               //14
    };                             
uint16_t  KeyboardColListPin[KeyBoardColCount] = {
    GPIO_PIN_3, GPIO_PIN_4, GPIO_PIN_5, GPIO_PIN_2,
    GPIO_PIN_1, GPIO_PIN_6, GPIO_PIN_7, GPIO_PIN_8,
    GPIO_PIN_9, GPIO_PIN_11,GPIO_PIN_12,GPIO_PIN_2,
    GPIO_PIN_3, GPIO_PIN_4
    };
GPIO_TypeDef *KeyboardRowListPort[KeyBoardRowCount] = { 
    GPIOA,       GPIOC,       GPIOB,      GPIOC,       GPIOA
    };

uint16_t  KeyboardRowListPin[KeyBoardRowCount] = {
    GPIO_PIN_15, GPIO_PIN_10, GPIO_PIN_5, GPIO_PIN_13, GPIO_PIN_0
    };

/* Matrix Connection END */

/*
Normal Key Map (NO FN&PN)
*/
uint8_t Normal_Value[KeyBoardRowCount][KeyBoardColCount]={
    {KeyESC, Key1, Key2,Key3,Key4,Key5,Key6,Key7,Key8,Key9,Key0,KeyMINUS,KeyEQUAL,KeyBACKSPACE},
    {KeyTAB, KeyQ,KeyW,KeyE,KeyR,KeyT, KeyY, KeyU,KeyI,KeyO,KeyP,KeyLBRACKET,KeyRBRACKET,KeyBSLASH},
    {KeyLCtrl, KeyA,KeyS,KeyD,KeyF,KeyG,KeyH,KeyJ,KeyK,KeyL,KeySEMICOLON, KeyQUOTA, 0,KeyRETURN},
    {KeyLShift, KeyZ,KeyX,KeyC,KeyV,KeyB,KeyN,KeyM,KeyCOMMA,KeyPERIOD,KeyFSLASH, 0, 0, KeyRShift},
    {KeyCAPSLOCK,KeyLAlt,KeyFN,0,0,KeySPACE,0,0,0,KeyPN,KeyRAlt,0,KeyRGui,KeyRCtrl}
};

uint8_t FN_Press_Value[KeyBoardRowCount][KeyBoardColCount]={
    {KeyGRAVE, KeyF1, KeyF2,KeyF3,KeyF4,KeyF5,KeyF6,KeyF7,KeyF8,KeyF9,KeyF10,KeyF11,KeyF12,KeyDELETE},
    {KeyTAB, KeyQ,KeyUARROW,KeyE,KeyR,KeyT, KeyY, KeyU,KeyINSERT,KeyO,KeyPRINTSCREEN,KeySCROLLLOCK,KeyRBRACKET,KeyBSLASH},
    {KeyLCtrl, KeyLARROW,KeyDARROW,KeyRARROW,KeyF,KeyG,KeyH,KeyJ,KeyK,KeyL,KeyHOME, KeyPAGEUP, 0,KeyRETURN},
    {KeyLShift, KeyZ,KeyX,KeyC,KeyV,KeyB,KeyVolDown,KeyVolUp,KeyMute,KeyEND,KeyPAGEDOWN, 0, 0, KeyRShift},
    {KeyCAPSLOCK,KeyLGui,KeyFN,0,0,KeySPACE,0,0,0,KeyPN,KeyRAlt,0,KeyRGui,KeyRCtrl}
};
