ZeshuLiu/Joker60_V3.5/(commit log)

2023-08-13 Start Building
    Using Stm32f401, f103 should be compatible
    [Joker60_V3.5.kicad_sch]
2023-08-15 230815_SchoolPC
    PCB layout
    CubeMX Pin configuration
    [Joker60_V3.5.kicad_sch, SGDBF-08-014P-H30.stp, SGDBF-08-020P-H30.stp]
2023-08-19 Bom revised
    [R-bom.xlsx, bom.csv]
2023-08-26 加入注释
2023-08-26 键盘正常使用&加入了fn层的HOME等按键
2023-10-16 U-Art (HARD PRO EXT)
    [Screen_UArt.kicad_pcb, Screen_UArt.kicad_sch, bom.csv, designators.csv, positions.csv]
2023-10-21 Uart Ext code
    [SGDBF-08-014P-H30.stp, SGDBF-08-020P-H30.stp, SGDBM-08-014P-H10.stp, SGDBM-08-020P-H10.stp, Serial_Dap_Screen.kicad_pcb, Serial_Dap_Screen.kicad_sch, Template.kicad_pcb, Template.kicad_sch]
2023-10-22 FN键按下后不会取消两层相同的按键的发送，整理了HIDreport的数组
2023-10-28 case for screen start
    [Screen_UArt.kicad_pcb, 外壳.SLDPRT, 盖子-bacspace.SLDPRT, 盖子-space.SLDPRT, 盖子_Screen.SLDPRT]
2023-10-29 新屏幕的盖子
    [1.69Screen.SLDPRT, 盖子_Screen.SLDPRT, 盖子_Screen.STL]
2023-11-04 U ART 驱动部分完成
    现在可以作为USB 转串口工作
    屏幕上显示波特率信息
    屏幕上预留显示发送接收计数以及十六进制显示的位置
2023-11-14 可以正常工作，键盘配置了函数数组，可以实现功能。目前可以PN + L 锁定键盘
2023-11-14 Revert "Merge branch 'main' of https://github.com/LiuZSChina/Joker60_V3.5"
    This reverts commit f7dbcc8b97f77df3b8c12e592d12a385700dcbc6, reversing
    changes made to 83d9d34583c502e71123a5b2a04d3d8099b75dd8.
    [usart.c]
2023-11-28 new part
    [外壳.SLDPRT, 手机架子.SLDPRT, 手机架子.STL, 手机架装配.SLDASM]
2023-12-08 串口调试助手二进制显示功能
2024-01-23 更改滤波次数为10次，优化等级为O3
2024-07-02 更改了滤波逻辑，滤波效果应该会更好
    主要是增加了松开按键的延时阶段，这样的话可以更好的滤波防止连击的情况出现
2025-12-26 移植到了CubeIDE工程，还未测试
    [1.69Screen.SLDPRT, Screen_UArt.kicad_sch, 外壳.STEP, 盖子-bacspace.SLDPRT, 盖子-space.SLDPRT, 盖子_Screen.3mf, 盖子_Screen.SLDPRT, 盖子_Screen.STL]
2025-12-26 重新整理，并未测试
2025-12-26 更新gitignore
2025-12-26 CUBEIDE测试OK；串口buffer改大（10kByte/s）测试完成
2025-12-29 清理USB CDC接收中的代码其余功能移至主循环进行【已测试】
2026-01-21 优化屏幕盖子
    [1.69Screen.SLDPRT, 前脚垫.SLDPRT, 前脚垫.STL, 后脚垫.SLDPRT, 后脚垫.STL, 外壳.SLDPRT, 外壳.STEP, 屏幕盖板.SLDDRW]
