ZeshuLiu/Joker60_V3.5/(notices)

Notices in the files:
Joker60_V3_5_Code/Composite/Core/Src/spi.c:
Copyright (c) 2023 STMicroelectronics.
All rights reserved.
This software is licensed under terms that can be found in the LICENSE file
